broncoracing/BCM/README.md

# Body Control Module
## BR23+ BCM

### Functions:
- Control cooling
  - Fan
  - Water pump
- Actuate shifting
  - Receive shift data over CAN
  - Activate pneumatic shifting actuators
- Any other CAN-controlled outputs
