broncoracing/BCM/pcb/DTM13-12PA-12PB/DTM1312PA12PBR008.step

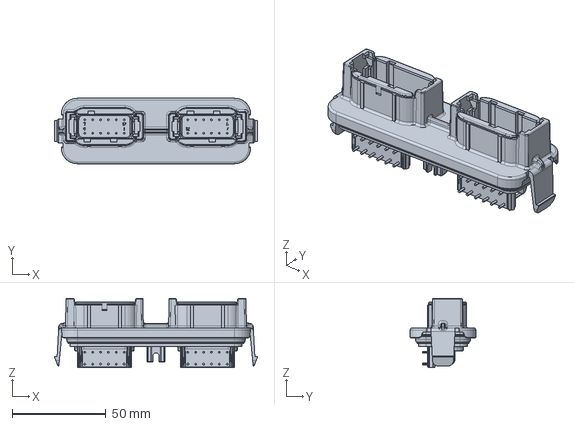
[picture p1: CAD file, 2023-02-09]
pcb/DTM13-12PA-12PB/DTM1312PA12PBR008.step
108.3 x 35.0 x 36.9 mm
