broncoracing/BCM/pcb/PCB.kicad_pcb

## KiCad design pcb/PCB.kicad_pcb (2023-03-26)

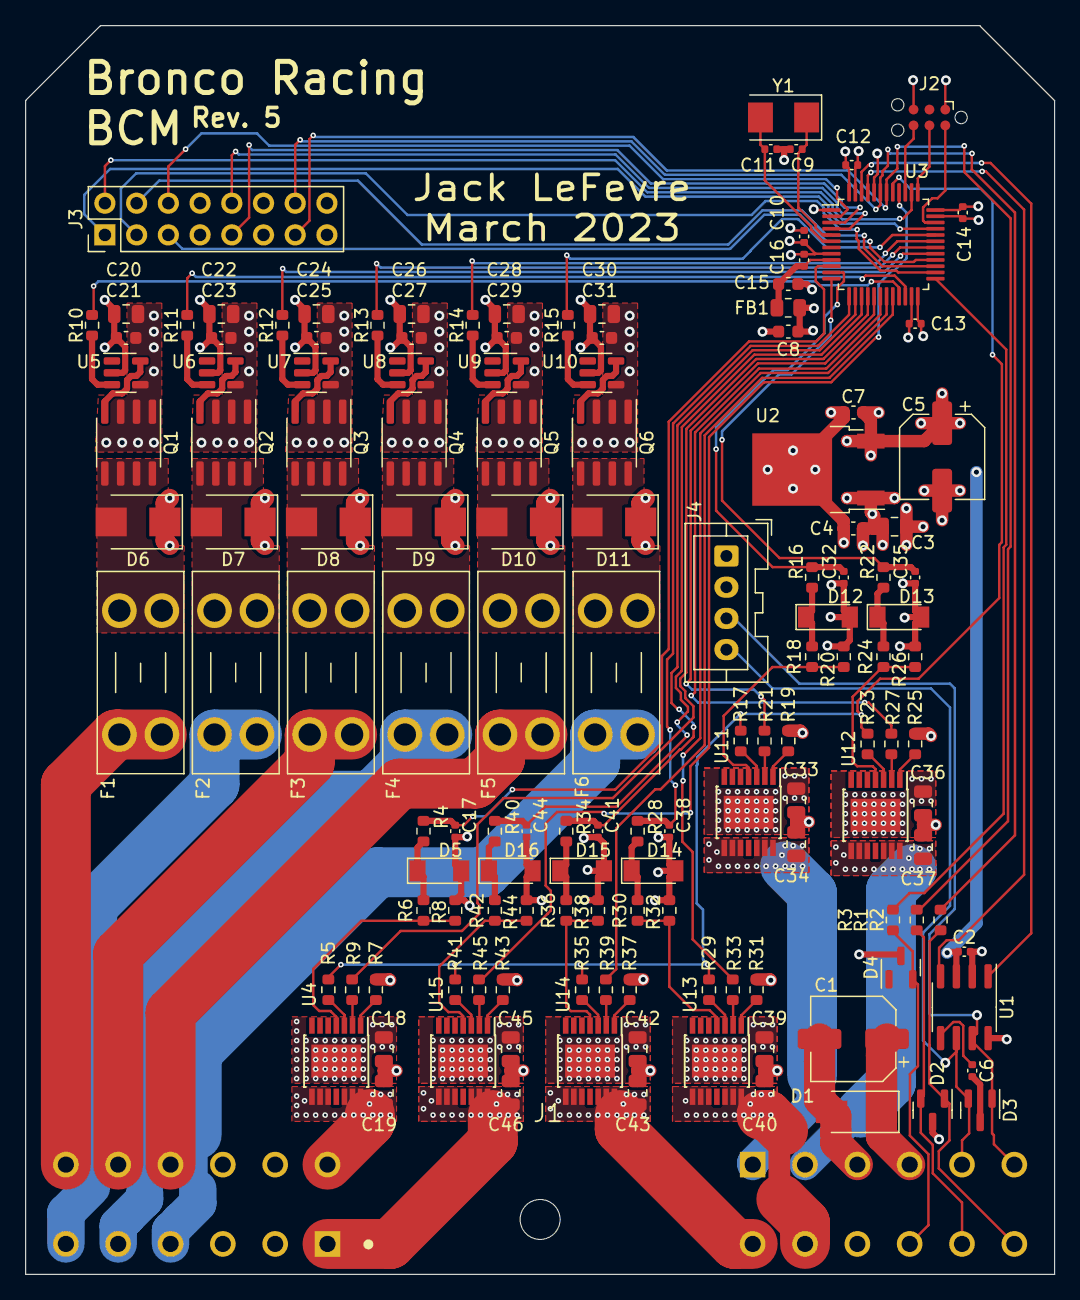
[picture p2: board PCB.kicad_pcb from above]

Board: 4 copper layers, 82.4 x 100.0 mm, 141 parts (0 on the bottom side), 108 nets.

Parts:
C1, C5: 100uF; CP_Elec_6.3x7.7
C2, C6, C10, C12, C13, C14, C16: 100n; C_0402_1005Metric
C3, C20, C22, C24, C26, C28, C30: 2.2uF; C_0805_2012Metric
C4, C7, C21, C23, C25, C27, C29, C31: 100nF; C_0603_1608Metric
C8: 4u7; C_0603_1608Metric
C9, C11: 30p; C_0402_1005Metric
C15: 1u; C_0603_1608Metric
C17, C32, C35, C38, C41, C44: 220p; C_0402_1005Metric
C18, C33, C36, C39, C42, C45: 100nF >25V; C_0805_2012Metric
C19, C34, C37, C40, C43, C46: 10nF >25V; C_0805_2012Metric
D1: 15-25V; D_SMA
D2, D4: SP0502BAHT; SOT-23
D3: ESDCAN02-2BWY; SOT-23
D5, D12, D13, D14, D15, D16: 7V; D_MiniMELF
D6, D7, D8, D9, D10, D11: SSB43L; D_SMB
F1, F2, F3, F4, F5, F6: Fuse; Fuseholder_Blade_Mini_Keystone_3568
FB1: 100R@100MHz; R_0805_2012Metric
H1: MountingHole_3.2mm_M3
J1: DTM1312PA12PBR008; TE_DTM1312PA12PBR008
J2: TC2030; Tag-Connect_TC2030-IDC-NL_2x03_P1.27mm_Vertical
J3: Conn_02x08_Top_Bottom; PinHeader_2x08_P2.54mm_Vertical
J4: JST B04B-XASK; JST_XA_B04B-XASK-1_1x04_P2.50mm_Vertical
Q1, Q2, Q3, Q4, Q5, Q6: Si4162DY; SOIC-8_3.9x4.9mm_P1.27mm
R1, R2, R3: 470; R_0603_1608Metric
R4, R5, R6, R7, R10, R11, R12, R13, R14, R15, R16, R17, R18, R19, R22, R23, R24, R25, R28, R29, R30, R31, R34, R35, R36, R37, R40, R41, R42, R43: 4.7k; R_0603_1608Metric
R8, R20, R26, R32, R38, R44: 1.2k; R_0603_1608Metric
R9, R21, R27, R33, R39, R45: 47; R_0603_1608Metric
U1: SN65HVD230; SOIC-8_3.9x4.9mm_P1.27mm
U2: LF33_TO252; TO-252-2
U3: STM32F103C8T6; LQFP-48_7x7mm_P0.5mm
U4, U11, U12, U13, U14, U15: BTS7004-1EPP; Infineon_PG-TSDSO-14-22
U5, U6, U7, U8, U9, U10: MCP1416; SOT-23-5
Y1: 8MHz; Crystal_SMD_5032-2Pin_5.0x3.2mm

Connections:
+3.3VA: C15.1, C16.1, FB1.2, U3.9 (VDDA)
+3V3: C2.1, C5.1, C7.1, C8.1, C10.1, C12.1, C13.1, C14.1, FB1.1, J2.1 (VCC), J3.8, J3.16, U1.3 (VCC), U2.3 (VO), U3.1 (VBAT), U3.24 (VDD), U3.36 (VDD), U3.48 (VDD)
+12V: C1.1, C3.1, C4.1, C18.1, C20.1, C21.1, C22.1, C23.1, C24.1, C25.1, C26.1, C27.1, C28.1, C29.1, C30.1, C31.1, C33.1, C36.1, C39.1, C42.1, C45.1, D1.1 (A1), D6.1 (K), D7.1 (K), D8.1 (K), D9.1 (K), D10.1 (K), D11.1 (K), J1.A3, J1.A10, J1.B4, J4.1, U2.1 (VI), U4.15 (VS), U5.2 (Vdd), U6.2 (Vdd), U7.2 (Vdd), U8.2 (Vdd), U9.2 (Vdd), U10.2 (Vdd), U11.15 (VS), U12.15 (VS), U13.15 (VS), U14.15 (VS), U15.15 (VS)
/High-side Channel 0/DEN: R5.1, R17.1, R23.1, R29.1, R35.1, R41.1, U3.41 (PB5)
/High-side Channel 0/Drive: R7.1, U3.16 (PA6)
/High-side Channel 0/Sense: C17.1, R4.1, U3.10 (PA0)
/High-side Channel 1/Drive: R19.1, U3.17 (PA7)
/High-side Channel 1/Sense: C32.1, R16.1, U3.11 (PA1)
/High-side Channel 2/Drive: R25.1, U3.18 (PB0)
/High-side Channel 2/Sense: C35.1, R22.1, U3.12 (PA2)
/High-side Channel 3/Drive: R31.1, U3.19 (PB1)
/High-side Channel 3/Sense: C38.1, R28.1, U3.13 (PA3)
/High-side Channel 4/Drive: R37.1, U3.20 (PB2)
/High-side Channel 4/Sense: C41.1, R34.1, U3.14 (PA4)
/High-side Channel 5/Drive: R43.1, U3.40 (PB4)
/High-side Channel 5/Sense: C44.1, R40.1, U3.15 (PA5)
/Low-side channel 0/Drive: R10.1, U3.21 (PB10)
/Low-side channel 1/Drive: R11.1, U3.22 (PB11)
/Low-side channel 2/Drive: R12.1, U3.29 (PA8)
/Low-side channel 3/Drive: R13.1, U3.30 (PA9)
/Low-side channel 4/Drive: R14.1, U3.31 (PA10)
/Low-side channel 5/Drive: R15.1, U3.32 (PA11)
/STM32/GPIO: R3.1, U3.25 (PB12)
/STM32/HSE_IN: C11.1, U3.6 (PD1), Y1.2
/STM32/HSE_OUT: C9.1, U3.5 (PD0), Y1.1
/STM32/UART_RX: J3.13, R2.1, U3.42 (PB6)
/STM32/UART_TX: J3.14, R1.2, U3.43 (PB7)
/STM32/UU0: J3.1, U3.33 (PA12)
/STM32/UU1: J3.2, U3.38 (PA15)
/STM32/UU2: J3.3, U3.26 (PB13)
/STM32/UU3: J3.4, U3.27 (PB14)
/STM32/UU4: J3.5, U3.28 (PB15)
/STM32/UU5: J3.6, U3.2 (PC13)
/STM32/UU6: J3.9, U3.3 (PC14)
/STM32/UU7: J3.10, U3.4 (PC15)
CAN+: D3.1 (K), J1.B6, J4.3, U1.7 (CANH)
CAN-: D3.2 (K), J1.B5, J4.4, U1.6 (CANL)
CANRX: U1.4 (R), U3.45 (PB8)
CANTX: U1.1 (D), U3.46 (PB9)
GND: C1.2, C2.2, C3.2, C4.2, C5.2, C7.2, C8.2, C9.2, C10.2, C11.2, C12.2, C13.2, C14.2, C15.2, C16.2, C17.2, C18.2, C19.2, C20.2, C21.2, C22.2, C23.2, C24.2, C25.2, C26.2, C27.2, C28.2, C29.2, C30.2, C31.2, C32.2, C33.2, C34.2, C35.2, C36.2, C37.2, C38.2, C39.2, C40.2, C41.2, C42.2, C43.2, C44.2, C45.2, C46.2, D1.2 (A2), D2.3 (A), D4.3 (A), D5.2 (A), D12.2 (A), D13.2 (A), D14.2 (A), D15.2 (A), D16.2 (A), J1.A2, J1.A11, J1.B3, J1.B10, J2.5 (GND), J3.7, J3.12, J3.15, J4.2, Q1.1 (S), Q1.2 (S), Q1.3 (S), Q2.1 (S), Q2.2 (S), Q2.3 (S), Q3.1 (S), Q3.2 (S), Q3.3 (S), Q4.1 (S), Q4.2 (S), Q4.3 (S), Q5.1 (S), Q5.2 (S), Q5.3 (S), Q6.1 (S), Q6.2 (S), Q6.3 (S), R8.2, R9.2, R20.2, R21.2, R26.2, R27.2, R32.2, R33.2, R38.2, R39.2, R44.2, R45.2, U1.2 (GND), U1.8 (Rs), U2.2 (GND), U3.8 (VSSA), U3.23 (VSS), U3.35 (VSS), U3.44 (BOOT0), U3.47 (VSS), U5.4 (GND), U6.4 (GND), U7.4 (GND), U8.4 (GND), U9.4 (GND), U10.4 (GND)
H0: C19.1, J1.A12, U4.8 (OUT), U4.9 (OUT), U4.10 (OUT), U4.12 (OUT), U4.13 (OUT), U4.14 (OUT)
H1: C34.1, J1.B1, U11.8 (OUT), U11.9 (OUT), U11.10 (OUT), U11.12 (OUT), U11.13 (OUT), U11.14 (OUT)
H2: C37.1, J1.B2, U12.8 (OUT), U12.9 (OUT), U12.10 (OUT), U12.12 (OUT), U12.13 (OUT), U12.14 (OUT)
H3: C40.1, J1.B11, U13.8 (OUT), U13.9 (OUT), U13.10 (OUT), U13.12 (OUT), U13.13 (OUT), U13.14 (OUT)
H4: C43.1, J1.B12, U14.8 (OUT), U14.9 (OUT), U14.10 (OUT), U14.12 (OUT), U14.13 (OUT), U14.14 (OUT)
H5: C46.1, J1.A1, U15.8 (OUT), U15.9 (OUT), U15.10 (OUT), U15.12 (OUT), U15.13 (OUT), U15.14 (OUT)
IO: D4.2 (K), J1.B9, R3.2
L0: F1.2, J1.A7
L1: F2.2, J1.A6
L2: F3.2, J1.A8
L3: F4.2, J1.A5
L4: F5.2, J1.A9
L5: F6.2, J1.A4
unnamed: C6.1, U1.5 (Vref)
unnamed: C6.2, D3.3 (A)
unnamed: D5.1 (K), R4.2, R6.2
unnamed: D6.2 (A), F1.1, Q1.5 (D), Q1.6 (D), Q1.7 (D), Q1.8 (D)
unnamed: D7.2 (A), F2.1, Q2.5 (D), Q2.6 (D), Q2.7 (D), Q2.8 (D)
unnamed: D8.2 (A), F3.1, Q3.5 (D), Q3.6 (D), Q3.7 (D), Q3.8 (D)
unnamed: D9.2 (A), F4.1, Q4.5 (D), Q4.6 (D), Q4.7 (D), Q4.8 (D)
unnamed: D10.2 (A), F5.1, Q5.5 (D), Q5.6 (D), Q5.7 (D), Q5.8 (D)
unnamed: D11.2 (A), F6.1, Q6.5 (D), Q6.6 (D), Q6.7 (D), Q6.8 (D)
unnamed: D12.1 (K), R16.2, R18.2
unnamed: D13.1 (K), R22.2, R24.2
unnamed: D14.1 (K), R28.2, R30.2
unnamed: D15.1 (K), R34.2, R36.2
unnamed: D16.1 (K), R40.2, R42.2
unnamed: Q1.4 (G), U5.5 (OUT)
unnamed: Q2.4 (G), U6.5 (OUT)
unnamed: Q3.4 (G), U7.5 (OUT)
unnamed: Q4.4 (G), U8.5 (OUT)
unnamed: Q5.4 (G), U9.5 (OUT)
unnamed: Q6.4 (G), U10.5 (OUT)
unnamed: R5.2, U4.3 (DEN)
unnamed: R6.1, R8.1, U4.4 (IS)
unnamed: R7.2, U4.2 (IN)
unnamed: R9.1, U4.1 (GND)
unnamed: R10.2, U5.3 (IN)
unnamed: R11.2, U6.3 (IN)
unnamed: R12.2, U7.3 (IN)
unnamed: R13.2, U8.3 (IN)
unnamed: R14.2, U9.3 (IN)
unnamed: R15.2, U10.3 (IN)
unnamed: R17.2, U11.3 (DEN)
unnamed: R18.1, R20.1, U11.4 (IS)
unnamed: R19.2, U11.2 (IN)
unnamed: R21.1, U11.1 (GND)
unnamed: R23.2, U12.3 (DEN)
unnamed: R24.1, R26.1, U12.4 (IS)
unnamed: R25.2, U12.2 (IN)
unnamed: R27.1, U12.1 (GND)
unnamed: R29.2, U13.3 (DEN)
unnamed: R30.1, R32.1, U13.4 (IS)
unnamed: R31.2, U13.2 (IN)
unnamed: R33.1, U13.1 (GND)
unnamed: R35.2, U14.3 (DEN)
unnamed: R36.1, R38.1, U14.4 (IS)
unnamed: R37.2, U14.2 (IN)
unnamed: R39.1, U14.1 (GND)
unnamed: R41.2, U15.3 (DEN)
unnamed: R42.1, R44.1, U15.4 (IS)
unnamed: R43.2, U15.2 (IN)
unnamed: R45.1, U15.1 (GND)
SWCLK: J2.4 (SWCLK), U3.37 (PA14)
SWDIO: J2.2 (SWDIO), U3.34 (PA13)
SWO: J2.6 (SWO), U3.39 (PB3)
UART_RX: D2.2 (K), J1.B8, R2.2
UART_TX: D2.1 (K), J1.B7, R1.1
