broncoracing/BCM/(threads)

Thread 13 (2023-02-20):

NRESET connected to 3.3v causes problems with firmware flashing

JackToaster, 2023-02-20:
Solved by disconnecting NRESET from everything

JackToaster, 2023-03-26:
Solved by #14

Closed 2023-03-26.
