broncoracing/BCM/firmware/Core/Src/main.c

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
/* Includes ------------------------------------------------------------------*/
#include "main.h"

/* USER CODE BEGIN Includes */
#include "pwm.h"
#include "can-ids/CAN.h"
/* USER CODE END Includes */

ADC_HandleTypeDef hadc1;
DMA_HandleTypeDef hdma_adc1;

CAN_HandleTypeDef hcan;

TIM_HandleTypeDef htim1;
TIM_HandleTypeDef htim2;

UART_HandleTypeDef huart1;

/* USER CODE BEGIN PV */
volatile uint16_t adc_values[7];
/* USER CODE END PV */

void SystemClock_Config(void);
static void MX_GPIO_Init(void);
static void MX_DMA_Init(void);
static void MX_CAN_Init(void);
static void MX_ADC1_Init(void);
static void MX_TIM1_Init(void);
static void MX_TIM2_Init(void);
static void MX_USART1_UART_Init(void);
/* USER CODE BEGIN PFP */
void can_irq(CAN_HandleTypeDef *pcan);
/* USER CODE END PFP */

/* USER CODE BEGIN 0 */

uint16_t u8_to_duty(uint8_t val) {
  return ((uint32_t)val) * 65535 / 255;
}

// CAN Interrupt handler. Called whenever a new CAN frame is received.
void can_irq(CAN_HandleTypeDef *pcan) {
  // Message header
  CAN_RxHeaderTypeDef msg;
  // Message data. Only filled with as much data as the message contained, the rest is garbage.
  uint8_t data[8];

  // Read the next CAN frame
  HAL_CAN_GetRxMessage(pcan, CAN_RX_FIFO0, &msg, data);
  if(msg.IDE == CAN_ID_STD) { // Standard CAN ID, we don't use extended IDs.
    switch (msg.StdId)
      {
      // BCM Cannot reboot with bootloader or else everything connected to it will lose power and fail to respond
      // case BOOTLOADER_ID:
      //   __NVIC_SystemReset(); // Reset to bootloader
      //   break;
      case BCM_COMMAND_EV_ID:
        // set PWM duties for low-side drivers
        // pumps are on/off only
        uint8_t accum_pump_duty = read_field_u8(&BCM_COMMAND_EV_L0_AccumPump, data);
        if(accum_pump_duty > 0) accum_pump_duty = 255;
      
        uint8_t motor_pump_duty = read_field_u8(&BCM_COMMAND_EV_L1_MotorPump, data);
        if(motor_pump_duty > 0) motor_pump_duty = 255;

        pwm_duties[0] = u8_to_duty(accum_pump_duty);
        pwm_duties[1] = u8_to_duty(motor_pump_duty);

        pwm_duties[2] = u8_to_duty(read_field_u8(&BCM_COMMAND_EV_L2_AccumFan, data));
        pwm_duties[3] = u8_to_duty(read_field_u8(&BCM_COMMAND_EV_L3_MotorFan, data));
        pwm_duties[4] = u8_to_duty(read_field_u8(&BCM_COMMAND_EV_L4_BrakeLight, data));
        pwm_duties[5] = u8_to_duty(read_field_u8(&BCM_COMMAND_EV_L5_Sound, data));

        update_pwm();
        
        // set high-side drivers
        HAL_GPIO_WritePin(H0_GPIO_Port, H0_Pin, read_field_u8(&BCM_COMMAND_EV_H0_ShutdownPower, data));
        HAL_GPIO_WritePin(H1_GPIO_Port, H1_Pin, read_field_u8(&BCM_COMMAND_EV_H1_DashboardPower, data));
        HAL_GPIO_WritePin(H2_GPIO_Port, H2_Pin, read_field_u8(&BCM_COMMAND_EV_H2_BSPDPower, data));
        HAL_GPIO_WritePin(H3_GPIO_Port, H3_Pin, read_field_u8(&BCM_COMMAND_EV_H3_AccumulatorPower, data));

        // dont let the VCU commit suicide
        // HAL_GPIO_WritePin(H4_GPIO_Port, H4_Pin, 0);

        HAL_GPIO_WritePin(H5_GPIO_Port, H5_Pin, read_field_u8(&BCM_COMMAND_EV_H5_InverterPower, data));
        break;

      // case BCM_COMMAND_ID:
      //   uint8_t water_pump_duty = read_field_u8(&BCM_COMMAND_water_pump_duty, data);
      //   uint8_t rad_fan_duty = read_field_u8(&BCM_COMMAND_radiator_fan_duty, data);
      //   uint8_t extra_fan_duty = read_field_u8(&BCM_COMMAND_extra_fan_duty, data);

      //   pwm_duties[2] = ((uint32_t)water_pump_duty) * 65535 / 100;
      //   pwm_duties[5] = ((uint32_t)rad_fan_duty) * 65535 / 100;
      //   pwm_duties[4] = ((uint32_t)extra_fan_duty) * 65535 / 100;
      //   update_pwm();

      //   uint8_t upshift = read_field_u8(&BCM_COMMAND_upshift, data);
      //   uint8_t downshift = read_field_u8(&BCM_COMMAND_downshift, data);
      //   uint8_t brake_light = read_field_u8(&BCM_COMMAND_brake_light, data);

      //   HAL_GPIO_WritePin(H1_GPIO_Port, H1_Pin, upshift);
      //   HAL_GPIO_WritePin(H4_GPIO_Port, H4_Pin, downshift);
      //   HAL_GPIO_WritePin(H3_GPIO_Port, H3_Pin, brake_light);
      //   break;
      default:
        // Default behavior for unrecognized CAN IDs. Probably just ignore.
        break;
      }
  }
  
}



/* USER CODE END 0 */

/**
  * @brief  The application entry point.
  * @retval int
  */
int main(void)
{
  /* USER CODE BEGIN 1 */
  // Relocate vector table to work with bootloader
  // THIS IS CRITICAL FOR THE APP TO WORK, DO NOT DELETE!
  SCB->VTOR = (uint32_t)0x08003000;
  /* USER CODE END 1 */

  /* MCU Configuration--------------------------------------------------------*/

  /* Reset of all peripherals, Initializes the Flash interface and the Systick. */
  HAL_Init();

  /* Configure the system clock */
  SystemClock_Config();

  /* Initialize all configured peripherals */
  MX_GPIO_Init();
  MX_DMA_Init();
  MX_CAN_Init();
  MX_ADC1_Init();
  MX_TIM1_Init();
  MX_TIM2_Init();
  MX_USART1_UART_Init();
  /* USER CODE BEGIN 2 */

  // Calibrate The ADC On Power-Up For Better Accuracy
  HAL_ADCEx_Calibration_Start(&hadc1);


  /* USER CODE END 2 */

  /* Infinite loop */
  /* USER CODE BEGIN WHILE */
  uint32_t output_sw_timer = 0;
  for(uint8_t i = 0; i < 6; ++i){
    pwm_duties[i] = 0;
  }

  HAL_GPIO_WritePin(H0_GPIO_Port, H0_Pin, 0);
  HAL_GPIO_WritePin(H1_GPIO_Port, H1_Pin, 0);
  HAL_GPIO_WritePin(H2_GPIO_Port, H2_Pin, 0);
  HAL_GPIO_WritePin(H3_GPIO_Port, H3_Pin, 0);
  HAL_GPIO_WritePin(H4_GPIO_Port, H4_Pin, 0);
  HAL_GPIO_WritePin(H5_GPIO_Port, H5_Pin, 0);
  

  // VCU is constantly on
  HAL_GPIO_WritePin(H4_GPIO_Port, H4_Pin, 1);

  // why not turn on the inverter too?
  HAL_GPIO_WritePin(H5_GPIO_Port, H5_Pin, 1);

  pwm_frequency_01 = 24;
  pwm_frequency_2345 = 24;
  update_pwm();
  init_pwm();

  while (1)
  {
    HAL_Delay(50); // Main Loop (Could be done with systick instead)

    // Toggle status LED
    HAL_ADC_Start_DMA(&hadc1, (uint32_t *)adc_values, 1);
    // //pwm_frequency_01 = (pwm_frequency_01 + 1) % 16;
    // for(uint8_t i = 0; i < 6; ++i) {
    //   pwm_duties[i] += 100;
    //   if(pwm_duties[i] < 0x6000) pwm_duties[i] = 0x6000;
    // }
    // update_pwm();

    // output_sw_timer ++;
    // if(output_sw_timer > 50) {
    //   HAL_GPIO_TogglePin(H0_GPIO_Port, H0_Pin);
    //   HAL_GPIO_TogglePin(H1_GPIO_Port, H1_Pin);
    //   HAL_GPIO_TogglePin(H2_GPIO_Port, H2_Pin);
    //   HAL_GPIO_TogglePin(H3_GPIO_Port, H3_Pin);
    //   HAL_GPIO_TogglePin(H4_GPIO_Port, H4_Pin);
    //   HAL_GPIO_TogglePin(H5_GPIO_Port, H5_Pin);
    //   output_sw_timer = 0;
    // }

    /* USER CODE END WHILE */

    /* USER CODE BEGIN 3 */
  }
  /* USER CODE END 3 */
}

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
