broncoracing/BCM/firmware/firmware.ioc

Mcu.UserName=STM32F103C8Tx
PA0-WKUP.Signal=ADCx_IN0
PA1.Signal=ADCx_IN1
PA10.Signal=S_TIM1_CH3
PA11.Signal=S_TIM1_CH4
PA13.Signal=SYS_JTMS-SWDIO
PA14.Signal=SYS_JTCK-SWCLK
PA2.Signal=ADCx_IN2
PA3.Signal=ADCx_IN3
PA4.Signal=ADCx_IN4
PA5.Signal=ADCx_IN5
PA6.GPIO_Label=H0
PA6.Signal=GPIO_Output
PA7.GPIO_Label=H1
PA7.Signal=GPIO_Output
PA8.Signal=S_TIM1_CH1
PA9.Signal=S_TIM1_CH2
PB0.GPIO_Label=H2
PB0.Signal=GPIO_Output
PB1.GPIO_Label=H3
PB1.Signal=GPIO_Output
PB10.Signal=S_TIM2_CH3
PB11.Signal=S_TIM2_CH4
PB2.GPIO_Label=H4
PB2.Signal=GPIO_Output
PB3.Signal=SYS_JTDO-TRACESWO
PB4.GPIO_Label=H5
PB4.Signal=GPIO_Output
PB5.GPIO_Label=DEN
PB5.Signal=GPIO_Output
PB6.Signal=USART1_TX
PB7.Signal=USART1_RX
PB8.Signal=CAN_RX
PB9.Signal=CAN_TX
PD0-OSC_IN.Signal=RCC_OSC_IN
PD1-OSC_OUT.Signal=RCC_OSC_OUT
