broncoracing/BCM/firmware/Core/Inc/main.h

#define H0_Pin GPIO_PIN_6
#define H0_GPIO_Port GPIOA
#define H1_Pin GPIO_PIN_7
#define H1_GPIO_Port GPIOA
#define H2_Pin GPIO_PIN_0
#define H2_GPIO_Port GPIOB
#define H3_Pin GPIO_PIN_1
#define H3_GPIO_Port GPIOB
#define H4_Pin GPIO_PIN_2
#define H4_GPIO_Port GPIOB
#define H5_Pin GPIO_PIN_4
#define H5_GPIO_Port GPIOB
#define DEN_Pin GPIO_PIN_5
#define DEN_GPIO_Port GPIOB
