broncoracing/BCM/(commit log)

2022-02-13 Created schematic and PCB (#6)
    * add components
    * Updated parts and routing
    Updated schematic to use new Smart switches and Micro. Also changed the drive channels
    * Corrected schematic
    * Corrected STM32 pinout, changed designators, added decoupling caps, and corrected passives for fets
    * Fixed net labels and other errors from previous commit
    * Fixed net labels and other errors from previous commit
    * Fixed connector pinout
    * Fixed connector pinout
    * Fixed connector pinout
    * Finished layout & routing
    * Added magical crystal power
    * Fix designator position
    * Final schematic changes
    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
    [3557-2.PcbLib, 3557-2.SchLib, BOM.xlsx, BR22-BCM.PrjPcb, BTS70012-1ESP.PcbLib, DTM13-12PA-R008.PcbLib, DTM13-12PA-R008.SchLib, DTM1312PA12PBR008.PcbLib]
2022-03-22 Added pdf schematic (#7)
2022-07-01 Implement BCM firmware (#11)
    * Implement BCM firmware
    * Fix submodules
    * Add debug print statements, set fan PWM period
    * Address feedback, cleanup formatting
    * Fix pin reset function to address pointer issues
    * Add watchdog
    * Tweak shift times, move watchdog
    * Testing fixes
    - change water temp to celsius
    - update print statements
    - update can ids
    - Update header params
    * Better printing, cleanup
    - Cleanup/organize header
    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
    [main.h]
2023-02-09 Switch to KiCAD, made rev 5 (#12)
    * Nuked the altium stuff
    * Updated to new template
    * Finished schematic
    * Started layout
    * Worked on layout
    * Added missing files for kibot
    * Worked on layout some more
    * Finish layout (still needs memes)
    * Fixed ERC
    * Added debug/test header
    * Switched to non-sketchy regulator
    * Bottom text
    [3557-2.PcbLib, 3557-2.SchLib, BOM.xlsx, BR22-BCM.PrjPcb, BTS70012-1ESP.PcbLib, DTM13-12PA-R008.PcbLib, DTM13-12PA-R008.SchLib, DTM1312PA12PBR008.PcbLib]
2023-03-26 Correct PCB to fix firmware flashing (#14)
    * Disconnected NRESET
    * Udpate date/revision of BCM
    [PCB.kicad_pcb, PCB.kicad_sch, STM32.kicad_sch]
2023-05-01 BCM Firmware (#15)
    * Made test firmware
    * Add can IDs
    * Fix fw to work with bootloader
    * remove unnecessary file
    * Honk
    * Update for IC car
    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
    [bcm.c, firmware.ioc, horn.c, main.c, main.h]
2023-05-11 fixed pwm init, add fuel pump output
    [main.c]
2024-05-01 fix duty cycle range
    [main.c]
2024-06-21 fix fan problem
